mx-c/ddr/README.md

# DDR
This repository aims at describing thoroughly a build of Dance Dance Revolution pad I made that works.
Its version 1.0 wood frame is hightly inspired by [Super Make Something]. 

## [DDR version 1.0](./v1.0)

### [Purchase list](./v1.0/purchaseList.md)

### [Electronic circuit](./v1.0/circuitDesign.md)

### [Arduino code](./v1.0/arduinoCode.md)

### [Frame](./v1.0/frame.md)
