mx-c/ddr/v1.0/README.md

[Home](../README.md)
_____________________________

# DDR version 1.0

## [Purchase list](./purchaseList.md)

## [Electronic circuit](./circuitDesign.md)

## [Arduino code](./arduino)

## [Frame](./frame.md)
_____________________________
[Home](../README.md)
