mx-c/ddr/v1.0/arduino/README.md

[Home](../README.md)    |   [Current Version](../) 
_____________________________

# Arduino code

main.ino has the necessary code to run the game.
It assumes that you set up the correct keys on the DDR software (for instance StepMania).

_____________________________
[Home](../README.md)
