mx-c/ddr/v1.0/frame.md

[Home](../README.md)    |   [Current Version](./)
__________________________

# Frame build

This section remains to be written. Coming soon.

It is largely borrowed from https://www.youtube.com/watch?v=nXjj9IXUaA4 . 

- [Frame supplies](./purchaseList.md#frame-supplies)
- [Frame Tools](./purchaseList.md#assets-for-the-frame-and-fastening)

--------------------------
[Home](../README.md)
