mx-c/ddr/v1.0/purchaseList.md

[Home](../README.md)    |   [Current Version](./)
_____________________________

# Purchase list

This was realized in France (Lyon), based on standards, units of that country. Good to also remember that sector voltage in France is 220v.

Below is what I used. Links are meant to give you the closest idea of what I used, and a price estimation. 

I purchased part of these components and tools at local stores. Some were part of larger sets, some I already had, etc.
 Up to you to find better bargain or quality elsewhere. For instance, I used BC337 transistors not because they were the best choice for the project, but because I had them already!

Also, Keep in mind that purchaising at local store will generally cost much more, but will be immediately available.

## Supplies

### Electronics and wiring supplies
- 4 [fuses 50 mA](https://fr.farnell.com/schurter/0034-6001/fuse-pcb-50ma-250v-fast-acting/dp/1211989)
- 1 [fuse 100 mA](https://fr.farnell.com/littelfuse/37001000430/fusible-tr5-quick-bfaible-100ma/dp/9515895)
- 1 [prototyping board](https://www.digikey.fr/catalog/en/partgroup/7050-100-board/8117) for soldering 100 mm x 100 mm
- *4 [transistors BC337](https://fr.farnell.com/multicomp/bc337/transistor-npn-to-92/dp/1574379)
- 4 resistors 6800 Ohm
- 4 resistors 47000 Ohm
- 4 resistors 4700 Ohm
- 1.5 meters [RGB LED strip](https://www.leroymerlin.fr/v3/p/produits/kit-ruban-led-1-5m-multicolore-e1500922964) 
- AC 220v -> DC 12v/1A (12W) transformer (comes with the LED strip)
- [1 Arduino Leonardo](https://www.ag-electronique.fr/modules-arduino/47-arduino-leonardo-velard-a000052-8058333491127.html)
- common aluminium foil for contacts
- 6 sheets of paper to strenghten contacts
- 1  spray bottle of [neoprene glue](https://www.leroymerlin.fr/v3/p/produits/colle-aerosol-neoprene-multi-usages-sader-200ml-e35093) 200 ml
- solder
- *6 [3-wires junction](https://www.leroymerlin.fr/v3/p/produits/5-minibornes-automatiques-a-levier-0-08-a-4-mm2-3-entrees-rigide-souple-wago-e1500746887) (I use 221 serie wago, 8mm height)
- * 10 or 20 [2-wires junction](https://www.leroymerlin.fr/v3/p/produits/10-minibornes-automatiques-a-levier-0-08-a-4-mm2-2-entrees-rigide-souple-wago-e1500804633) 
- 3.5 m red wire, ideally 0.3 mm2 monofilament (you should be using 2.5m)
- 3.5 m black wire ideally 0.3 mm2 monofilament (you should be using 2.5m)
- 5 m green wire ideally 0.3 mm2 monofilament(you should be using 3.5m)
- 1 [cable clamp](https://www.leroymerlin.fr/v3/p/produits/lot-de-25-colliers-diam-2-a-50-mm-l-195-mm-e1400914882)
- [insulating tape of different colors](https://www.leroymerlin.fr/v3/p/produits/lot-de-6-rubans-adhesifs-voltman-l-5-m-x-l-15-mm-e181273) (red, black, green, yellow, blue, orange)
- 1 wooden box with enough room to enclose the Arduino leonardo (recycled)

### Frame supplies
- 1 base board MDF 1220 mm x 1220 mm x 15mm
- 5 stationary panels MDF 380 mm x 380 mm x 15 mm
- 4 button panels MDF 380 mm x 380 mm x 10 mm
- 4 riser panels Birch 30 mm x 30 mm x 3 mm
- *cleat MDF 4880 mm x 40 mm x 18 mm (45° angles done with miter box)
- 20 screw covers
- [6 meters phone insulating compriband with 3-7 mm expansion capacity](https://www.amazon.fr/Compriband-%C3%A9tanche-fen%C3%AAtres-Largeur-15/dp/B07F812Z88)
- 1 sheet of [low grit sandpaper](https://www.leroymerlin.fr/v3/p/produits/feuille-abrasive-230-x-280-mm-grains-40-e55263) (for chamfers)
- 1 [bottle of wood glue](https://www.leroymerlin.fr/v3/p/produits/colle-a-bois-rapide-special-materiaux-sader-250g-e35131) 250g

### Fastening supplies
- 24 screws Ø 7mm / 1.5mm length 
- 32  screws  Ø 8mm / 25 mm length
- [8 washers Ø 6mm inside hole ( Ø 20mm outside)](https://www.castorama.fr/rondelles-plates-larges-de-reparation-en-acier-au-carbone-o-6mm-10-pieces/3663602753995_CAFR.prd)

### Finish and rendering supplies

- 0.5 L of white [primer](https://www.leroymerlin.fr/v3/p/produits/sous-couche-avant-peinture-sol-interieur-luxens-blanc-0-5-l-e1401134107)
- 0.5 L of [paint](https://www.leroymerlin.fr/v3/p/produits/peinture-sol-interieur-haute-resistance-luxens-gris-galet-n-1-0-5-l-e1400829458) (colour of your choosing)
- a big [plastic tarpolin](https://www.leroymerlin.fr/v3/p/produits/peinture-droguerie/rouleau-pinceau-et-bache-de-protection/bache-ruban-de-masquage-et-combinaison-l1308221680) to protect ground where you paint
- 1 sheet of high grit sandpaper

## Assets (tools)

### Assets for electronics
- 1 [multimeter](https://www.amazon.fr/Velleman-dvm835-Multim%C3%A8tre-num%C3%A9rique-500-1999-points/dp/B07BDVQ951) (resistance, voltage, intensity, led testing and sound upon connectivity). 
- 1 [soldering Iron](https://www.velleman.eu/products/view/?country=fr&lang=fr&id=349590)
- 1 [breadboard](https://fr.farnell.com/mcm/21-18936/carte-de-prototypage-55-x-83-mm/dp/2855018?st=breadboard) (for testing purposes)
- optional but recommended: drill and small [circular saw blade](https://www.leroymerlin.fr/v3/p/produits/fraise-scie-a-fente-diam-45-mm-wolfcraft-e190508) fit for your drill
- 2 aligator clips (for testing purposes)
- 1 cutter

### Assets for the frame and fastening
- 1 [drill](https://www.leroymerlin.fr/v3/p/perceuse-l1501561703?queryredirect=perceuse)
- [a drill-bit set for wood](https://www.leroymerlin.fr/v3/p/produits/lot-de-8-meches-a-bois-robustline-diam-3-a-10-mm-bosch-e1501847408)
- 1 [wood scissors (width: 20mm)](https://www.leroymerlin.fr/v3/p/produits/ciseaux-de-sculpteur-dexter-de-16-a-20-mm-e56114)
- 1 [clamp](https://www.leroymerlin.fr/v3/p/produits/presse-a-manche-dexter-300-mm-e51379)
- 1 [miter box](https://www.leroymerlin.fr/v3/p/produits/boite-a-onglet-manuelle-neuhofer-e1501676842) 
- 1 [hot glue gun](https://www.castorama.fr/pistolet-a-colle-sans-fil-rapid-cg-270/3221633029948_CAFR.prd)
- 1 [tape measure](https://www.castorama.fr/metre-a-ruban-facom-3-m-x-16-mm/3148517125001_CAFR.prd)
- 1 [manual saw](https://www.leroymerlin.fr/v3/p/produits/scie-universelle-e1500657807)
- optional but recommanded if you cut all panels yourself: [jigsaw](https://www.castorama.fr/scie-sauteuse-bosch-pst7200e/3165140817837_CAFR.prd)
- pencil, rubber, ruler
- optional but recommanded for angle precision: compass
- 1 bucket
- 1 wooden board to cut with cutter on (recycled)
- 1 big screwdrivers
- 1 small screwdriver

### Finish and rendering assets
- 1 [small paint roll](https://www.leroymerlin.fr/v3/p/produits/kit-d-outils-pour-peinture-mur-et-plafond-dexter-e1401293955)
- 1 [paint brush](https://www.leroymerlin.fr/v3/p/produits/pinceau-plat-pour-peindre-dexter-30-mm-e1401395484)
- 1 [paint tray](https://www.leroymerlin.fr/v3/p/produits/bac-a-peinture-rouleau-180-mm-nespoli-e183535)
- 1 towel

_____________________________

[Home](../README.md)
