mx-c/ddr/(commit log)

2019-05-08 pcb real commented
2019-05-09 added wire to purchase
2019-05-09 size of filament
2019-05-11 added frame and arduino
